Rishabh-1803/Health-Monitoring-System-using-HAL/ESP32/main_code/main/project_config.h

/**
 * project_config.h — ESP32-S3 Phase 2B configuration
 *
 * FreeRTOS priorities + stack sizes for the 2 tasks that run in Phase 2B.
 */
#ifndef PROJECT_CONFIG_H
#define PROJECT_CONFIG_H

/* Task priorities (higher = higher priority) */
#define TASK_UART_RX_PRIO       5
#define TASK_UART_TX_PRIO       4

/* Stack sizes (in words; ESP32 word = 4 bytes) */
#define TASK_UART_RX_STACK      4096
#define TASK_UART_TX_STACK      2048

/* Timing */
#define HEARTBEAT_PERIOD_MS     1000
#define COMM_FAIL_TIMEOUT_MS   5000

/* Answer the STM32 bring-up "echo" probe (menu option 7). 0 = disabled. */
#ifndef HMS_UART_ECHO_PROBE
#define HMS_UART_ECHO_PROBE 1
#endif

/* ------------------------------------------------------------------ */
/*  Optional flash storage (LittleFS). Set to 0 when the esp_littlefs
 *  component is unavailable — the system degrades to RAM + NVS.       */
/* ------------------------------------------------------------------ */
#ifndef HMS_USE_LITTLEFS
#define HMS_USE_LITTLEFS   0
#endif

#endif /* PROJECT_CONFIG_H */
