Rishabh-1803/Health-Monitoring-System-using-HAL/ESP32/main_code/main/Tasks/task_diagnostics.h

/**
 * @file    task_diagnostics.h
 * @brief   FreeRTOS task: periodic health sweep + log heartbeat.
 */
#ifndef TASK_DIAGNOSTICS_H
#define TASK_DIAGNOSTICS_H

void task_diagnostics_start(void);

#endif /* TASK_DIAGNOSTICS_H */
