Rishabh-1803/Health-Monitoring-System-using-HAL/ESP32/main_code/main/Tasks/task_watchdog.h

/**
 * @file    task_watchdog.h
 * @brief   FreeRTOS task: TWDT configuration + application supervisor.
 */
#ifndef TASK_WATCHDOG_H
#define TASK_WATCHDOG_H

void task_watchdog_start(void);

#endif /* TASK_WATCHDOG_H */
