Rishabh-1803/Health-Monitoring-System-using-HAL/ESP32/main_code/main/Tasks/task_webserver.h

/**
 * @file    task_webserver.h
 * @brief   FreeRTOS task: start HTTP+WS once a serving context exists.
 */
#ifndef TASK_WEBSERVER_H
#define TASK_WEBSERVER_H

void task_webserver_start(void);

#endif /* TASK_WEBSERVER_H */
