Rishabh-1803/Health-Monitoring-System-using-HAL/ESP32/main_code/main/Tasks/task_uart_tx.h

/**
 * @file    task_uart_tx.h
 * @brief   FreeRTOS task: send heartbeat packets to STM32 every 1 second.
 */
#ifndef TASK_UART_TX_H
#define TASK_UART_TX_H

#include <stdint.h>

/**
 * Create the UART TX task. Call once at boot.
 */
void task_uart_tx_start(void);

/** Heartbeats successfully transmitted since boot. */
uint32_t task_uart_tx_get_packets(void);

#endif /* TASK_UART_TX_H */
