Rishabh-1803/Health-Monitoring-System-using-HAL/ESP32/main_code/main/Drivers/led.c

/**
 * led.c — Onboard RGB LED driver (if available on DevKit)
 *
 * Phase 1: skeleton only. Implementation: Phase 3.
 * Reference: docs/ARCHITECTURE.md and docs/UART_PROTOCOL_SPEC.md
 */

#include "led.h"

/* TODO: Phase 3 — implement functions here */
