Rishabh-1803/Health-Monitoring-System-using-HAL/ESP32/main_code/main/Protocol/crc16.c

/**
 * crc16.c — CRC-16/CCITT implementation (spec §7)
 *
 * Phase 1: skeleton only. Implementation: Phase 2.
 * Reference: docs/ARCHITECTURE.md and docs/UART_PROTOCOL_SPEC.md
 */

#include "crc16.h"

/* TODO: Phase 2 — implement functions here */
