Rishabh-1803/Health-Monitoring-System-using-HAL/ESP32/main_code/main/Protocol/packet.c

/**
 * packet.c — Encode/decode packets (state machine from spec §9)
 *
 * Phase 1: skeleton only. Implementation: Phase 2.
 * Reference: docs/ARCHITECTURE.md and docs/UART_PROTOCOL_SPEC.md
 */

#include "packet.h"

/* TODO: Phase 2 — implement functions here */
