Rishabh-1803/Health-Monitoring-System-using-HAL/(commit log)

2026-08-18 Change license to proprietary software and IP license
    Updated the license from Creative Commons to a proprietary software license, outlining the restrictions and rights associated with the Protected Materials.
2026-08-19 Setting ESP32S3 to connect with STM32
    [partitions.csv]
2026-08-22 chore: stop tracking regenerable build output
    The ESP-IDF build/ directories for both freertos-warmup and main_code were
    committed by mistake, adding ~45 MB and 670 files of CMake/Ninja output to
    the repository. These are fully regenerated by 'idf.py build' and should
    never have been version controlled.
    - untrack ESP32/freertos-warmup/build and ESP32/main_code/build
    - untrack sdkconfig.old (editor backup; sdkconfig itself stays tracked)
    - extend .gitignore: build/, managed_components/, sdkconfig.old, *.bin,
    *.map, CubeIDE Debug/ and Release/, and Office ~$* lock files
    Files remain on disk; only the index is updated.
2026-10-05 ESP32 and STM32 communication sarted and link is working
2026-10-05 Phase 3: STM32 continuous telemetry application
    - app_telemetry.c: 10ms cooperative loop sampling DS18B20 (non-blocking
    state machine), ACS712 (64x averaged + EMA), SW-420 (debounced edges/s
    sliding window); hysteresis alarm engine; MSG_TELEMETRY @ configurable
    50..1000ms + MSG_HEARTBEAT @ 1Hz; command handling with ACK/NAK for
    SET_THRESHOLD / SET_SAMPLE_RATE / LED / BUZZER_OFF / RESET_ALARM /
    REBOOT / GET_STATUS; register-level IWDG (~33s) fed by the loop
    - app_init.c: app-first boot selector (3s console wait + 3s key window
    -> menu), menu item 'r' re-runs telemetry, keypress exits app to menu
    - console.c: key poll + readline feed the IWDG (bench-mode keep-alive)
    - LED mapping: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
    [app_init.c, app_telemetry.c, app_telemetry.h, console.c]
2026-10-05 Phase 4: ESP32 telemetry pipeline (decode, state cache, acknowledged commands)
    - history_ring.c: pure-C 3600x16B ring (1h @ 1Hz), host-testable
    - json_util.c: bounded JSON writer with escaping, host-testable
    - dashboard_data.c: mutex-guarded live state (telemetry, alarms, events,
    thresholds mirror, wifi/esp stats, link counters) + status JSON builder
    - command_dispatcher.c: synchronous ESP32->STM32 commands with ACK/NAK
    matching, 3 bounded retries, seq from 0x8000, convenience wrappers
    - task_uart_rx.c: full dispatch (telemetry/alarm/status/ack/nak/debug-log)
    + packet counters
    - task_uart_tx.c: comm-fail state mirrored into dashboard_data
    - uart_link.c: TX mutex (heartbeat vs command s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
2026-10-05 Phase 5: WiFi manager + HTTP/WebSocket server + live web dashboard
    - wifi_manager.c: NVS credentials, STA with 10-retry backoff, fallback
    SoftAP 'monitor-setup' + hand-rolled UDP:53 DNS hijack (captive portal),
    save->NVS->reboot provisioning flow
    - http_server.c: embedded static assets (EMBEDFILES), REST API (status,
    threshold, rate, led, alarm reset, reboot-stm32, wifi save/state),
    history endpoint with server-side decimation to <=720 pts + 1KB chunk
    streaming, captive-portal redirects (/generate_204 etc.)
    - websocket_server.c: /ws handler w/ per-session fd registry, async
    broadcast via httpd_queue_work + httpd_ws_send_frame_async, lazy prune
    - task_dashboard.c: 1Hz history samp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
    [main.c, task_dashboard.c, task_dashboard.h, task_webserver.c]
2026-10-05 Phase 6: ESP32 CLI (esp_console REPL over the USB serial console)
    - cli.c: 13 commands - status (snapshot view), link counters, heap,
    uptime, hist <n>, thr get/set, rate, led, alarm-reset, reboot-stm32,
    reboot, wifi show/set/clear; sscanf-based args (no argtable3 dep),
    1.5s interactive STM32 command budget
    - dashboard_data: plain-C snapshot accessor for the CLI
    - task_cli.c: REPL bootstrap wrapper (esp_console owns the task)
    - REPL task intentionally not TWDT-subscribed (idle prompts)
    [cli.c, cli.h, main.c, task_cli.c]
2026-10-05 Phase 7: watchdogs, supervisor, logging, diagnostics, LittleFS storage
    - task_watchdog.c: TWDT reconfigured 15s panic (uart_rx/tx/dashboard
    subscribe + reset per pass); supervisor escalates silent STM32
    (60s -> reboot cmd, 120s -> self reboot) only when link was ever up;
    low-heap logger
    - system_stats.c: CPU load via idle-task runtime accounting
    (FREERTOS_GENERATE_RUN_TIME_STATS), stack watermarks, CLI task table
    - logger.c: 64-line incident ring + JSON/console dumps + flash flush;
    hooks in rx alarms, comm transitions, wifi changes
    - littlefs_storage.c (HMS_USE_LITTLEFS, graceful no-op off): config.json,
    1/min history CSV w/ 256KB rotation, bounded log file; esp_littlefs
    manage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
    [partitions.csv]
2026-10-05 Phase 8: historical charts — zero-dependency canvas engine
    - 3 live line charts (temp/current/vibration est. g), 1m/5m/15m/1h
    windows, auto-scaled Y with headroom, grid + tick labels
    - dashed threshold line per channel (kept inside the Y range)
    - live endpoint dot, n/min/avg/max stats overlay, HiDPI (DPR) aware,
    resize handling; 1 Hz redraw driven by the WS status stream
    - history backfill via /api/history (server-side decimation to <=720
    points, chunked streaming); live appends keep charts current between
    refetches; auto-refetch on WS (re)connect
2026-10-05 Phase 9: host unit tests, soak-test tool, integration test plan
    - tests/host: 51 checks over crc16 (independent CCITT-FALSE vectors),
    packet codec (roundtrip/resync/corruption/guards), history_ring
    (ordering/wrap/window), json_util (escaping/truncation/scanners) —
    same source files as the firmware, run with plain gcc; verified green
    - tools/soak_test.py: stdlib-only integration test — minimal RFC6455
    WS client, 1Hz push-rate + telemetry-age + finiteness assertions,
    threshold alarm drill (raise/clear/reset via REST), history checks,
    CSV sample export, manual watchdog-drill hints
    - docs/TEST_PLAN.md: 9-section gate — unit -> bringup menu -> app mode
    -> ESP32 boot -> dashboa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
    [test_host.c]
2026-10-05 Docs: protocol spec, architecture, test plan references, READMEs
    - docs/UART_PROTOCOL_SPEC.md: full wire format (frames, 16 message
    types, payload tables, ACK/NAK exchange, alarm bits + hysteresis,
    units-honesty notes, comm-fail rules)
    - docs/ARCHITECTURE.md: design principles, module maps both MCUs, task
    + rate tables, boot ladders, failure model, repo map
    - root README: quick start, hardware map, verification status
    - ESP32 README: full rewrite (build, provisioning, services, REST API)
    - STM32 README: telemetry-app boot mode + IWDG keep-alive notes
2026-10-05 fix: drop unused linenoise include (real path is linenoise/linenoise.h; esp_console.h suffices)
    [cli.c]
2026-10-06 Compiling errors of ESP32S3 and STM32 resolved
    [app_telemetry.c, bringup_config.h, ina219.c, ina219.h, mpu6050.c, mpu6050.h]
2026-10-07 All sensors and webpage works in sync
2026-10-07 Now the device fault and minor spikes also get proper buzzer and updates
    [app_init.c, app_telemetry.c, ina219.c, stm32-bringup.ioc, task_dashboard.c, task_dashboard.h, task_uart_rx.c]
